tatsuya-iizuka-1011/eagle/SunnyBuddy-v13 2/SunnyBuddy-v13.brd

## EAGLE design SunnyBuddy-v13 2/SunnyBuddy-v13.brd (2016-01-27)

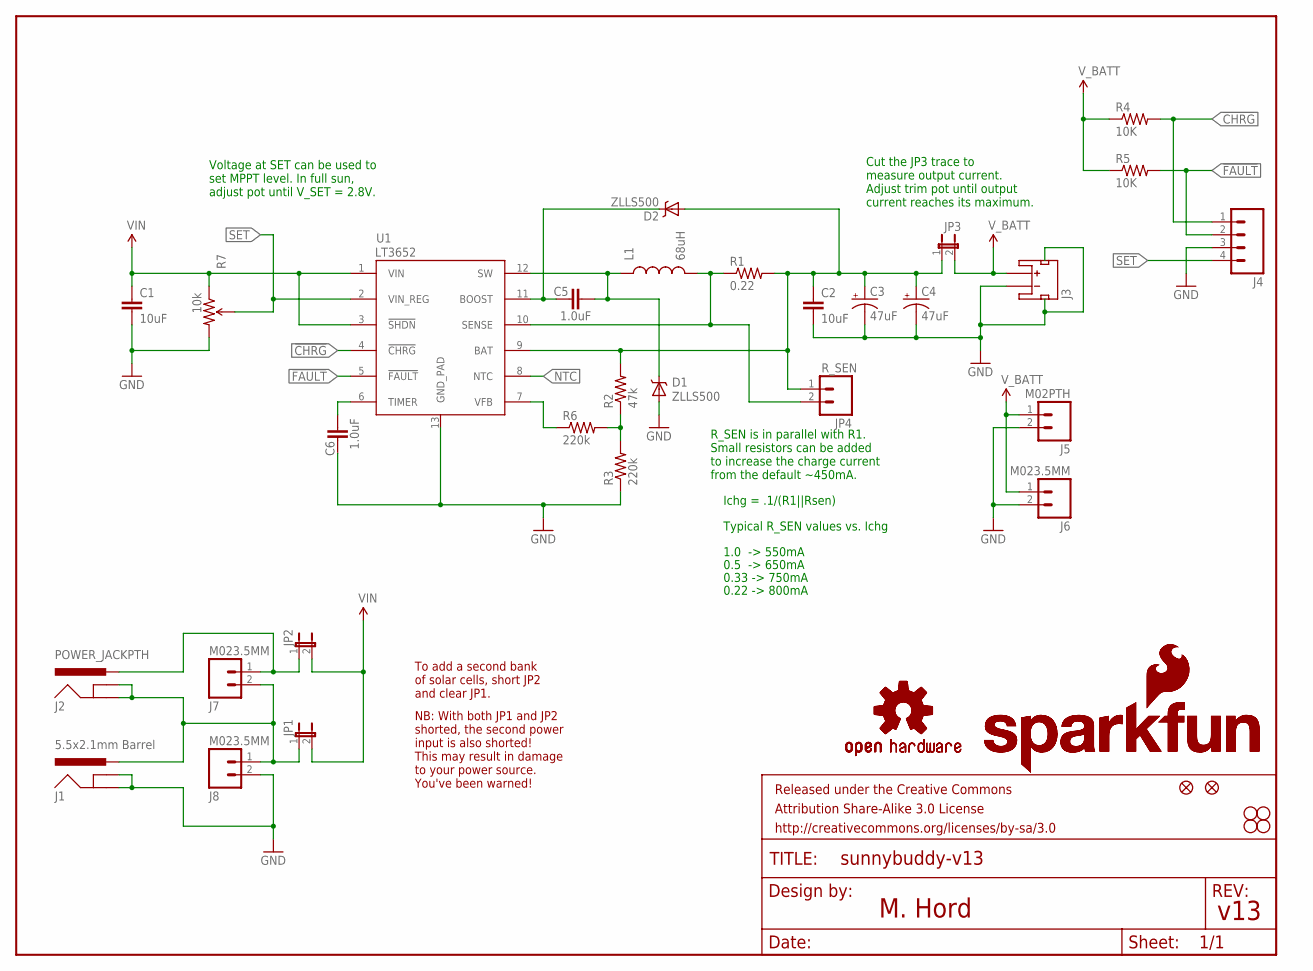
[picture p1: schematic SunnyBuddy-v13.sch]

Parts:
C1: 10uF; 1210
C2: 10uF; 1206
C3, C4: 47uF; EIA3528
C5, C6: 1.0uF; 0603-CAP
D1, D2: ZLLS500; SOT23
FID1, FID2: FIDUCIAL1X2; FIDUCIAL-1X2
FRAME1: FRAME-LETTER; CREATIVE_COMMONS
J1: 5.5x2.1mm Barrel; POWER_JACK_SMD
J2: POWER_JACKPTH; POWER_JACK_PTH
J3: JST_2MM_MALE; JST-2-SMD
J4: M04PTH; 1X04
J5: M02PTH; 1X02
J6, J7, J8: M023.5MM; SCREWTERMINAL-3.5MM-2
JP1: JUMPER-2SMD-NC; SJ_2S
JP2: JUMPER-2SMD-NO; SJ_2S-NO
JP3: JUMPER-PTH-2-NC; PTH-JUMPER-NC_BOTTOM_NO_SILK
JP4: R_SEN; 1X02
L1: 68uH; CR75
LOGO1: SFE_LOGO_NAME_FLAME.2_INCH; SFE_LOGO_NAME_FLAME_.2
LOGO2: OSHW-LOGOM; OSHW-LOGO-M
LOGO3: OSHW-LOGOS; OSHW-LOGO-S
LOGO4: SFE_LOGO_NAME_FLAME.3_INCH; SFE_LOGO_NAME_FLAME_.3
R1: 0.22; 0805
R2: 47k; 0603-RES
R3, R6: 220k; 0603-RES
R4, R5: 10K; 0603-RES
R7: 10k; TRIMPOT-3MM
STANDOFF1, STANDOFF2, STANDOFF3, STANDOFF4: STAND-OFF
U1: LT3652; MSOP-12_GND

Connections:
!CHRG: J4.1, R4.2, U1.4 (!CHRG)
!FAULT: J4.2, R5.2, U1.5 (!FAULT)
BOOST: C5.1, D2.3 (C), U1.11 (BOOST)
FB: R2.1, R3.2, R6.2
GND: C1.2, C2.2, C3.C (-), C4.C (-), C6.1, D1.1 (A), J1.GND (GNDBREAK), J1.P$4 (GND), J3.1 (-), J3.NC1 (PAD1), J3.NC2 (PAD2), J4.3, J5.2, J6.2, J8.2, R3.1, R7.3 (CW), U1.13 (GND_PAD)
unnamed: R6.1, U1.7 (VFB)
unnamed: C2.1, C3.A (+), C4.A (+), D2.1 (A), JP3.1, JP4.1, R1.2, R2.2, U1.9 (BAT)
unnamed: J1.VIN0 (PWR), J2.GND, J2.GNDBREAK, J7.2, J8.1, JP1.1
NTC: U1.8 (NTC)
SENSE: JP4.2, L1.P$2 (2), R1.1, U1.10 (SENSE)
SET: J4.4, R7.2 (WIPER), U1.2 (VIN_REG)
SFSASDF: J2.PWR, J7.1, JP2.1
SW: C5.2, D1.3 (C), L1.P$1 (1), U1.12 (SW)
TIMER: C6.2, U1.6 (TIMER)
VIN: C1.1, JP1.2, JP2.2, R7.1 (CCW), U1.1 (VIN), U1.3 (!SHDN)
V_BATT: J3.2 (+), J5.1, J6.1, JP3.2, R4.1, R5.1

Notes on the sheet:
To add a second bank of solar cells, short JP2 and clear JP1.
NB: With both JP1 and JP2 shorted, the second power input is also shorted! This may result in damage to your power source. You've been warned!
v13
M. Hord
Cut the JP3 trace to measure output current. Adjust trim pot until output current reaches its maximum.
R_SEN is in parallel with R1. Small resistors can be added to increase the charge current from the default ~450mA.
0.22 -> 800mA
Ichg = .1/(R1||Rsen)
Typical R_SEN values vs. Ichg
1.0 -> 550mA
0.33 -> 750mA
0.5 -> 650mA
Voltage at SET can be used to set MPPT level. In full sun, adjust pot until V_SET = 2.8V.

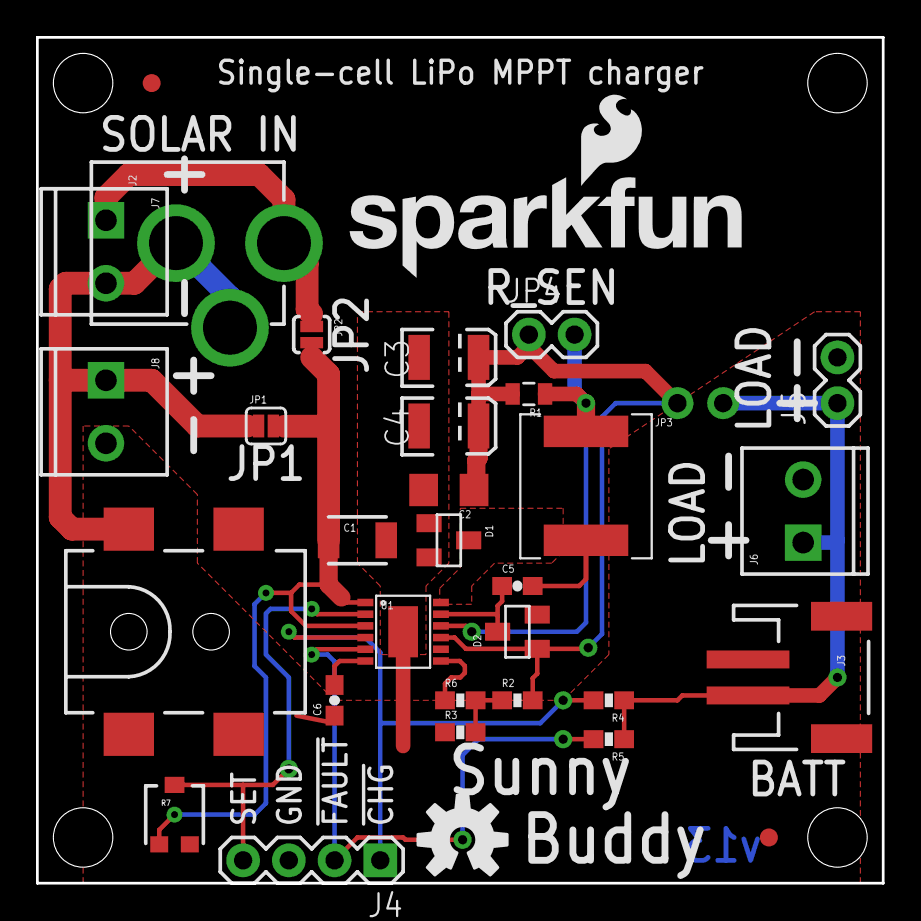
[picture p2: board SunnyBuddy-v13.brd from above]

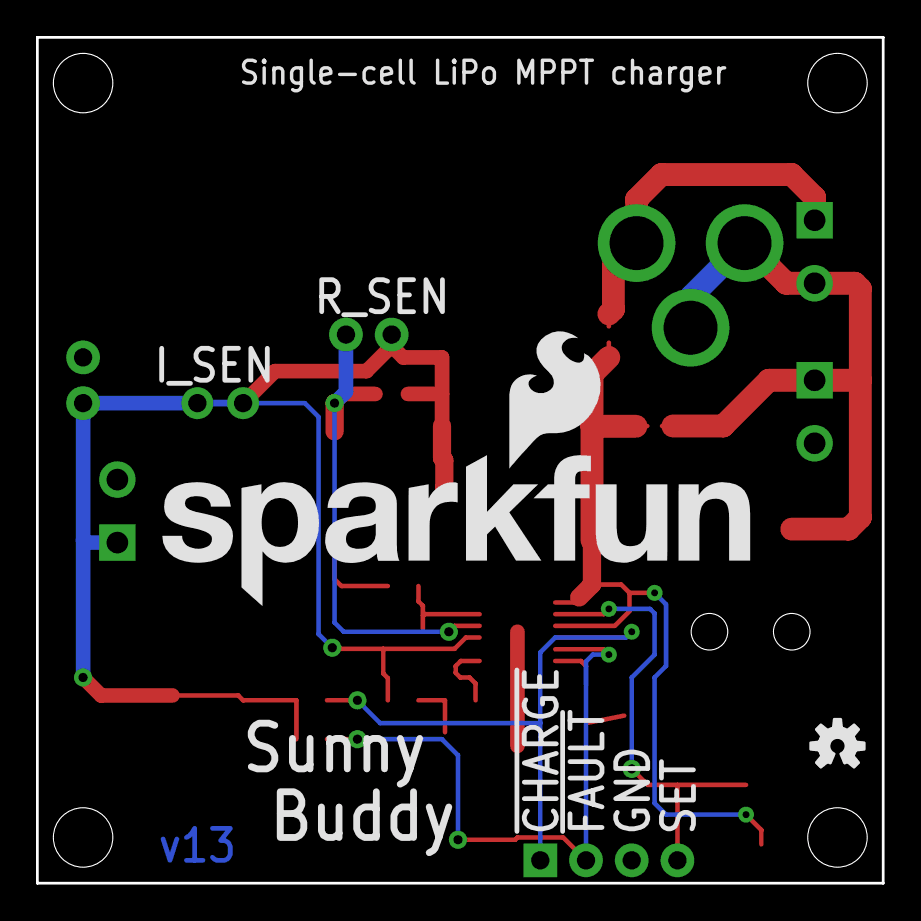
[picture p3: board SunnyBuddy-v13.brd from below]

Board: 2 copper layers, 47.0 x 47.0 mm, 40 parts (2 on the bottom side), 15 nets.
